herrjacob48-ui/inverted-pendulum-project/hardware/drawings/IP-M-002.png

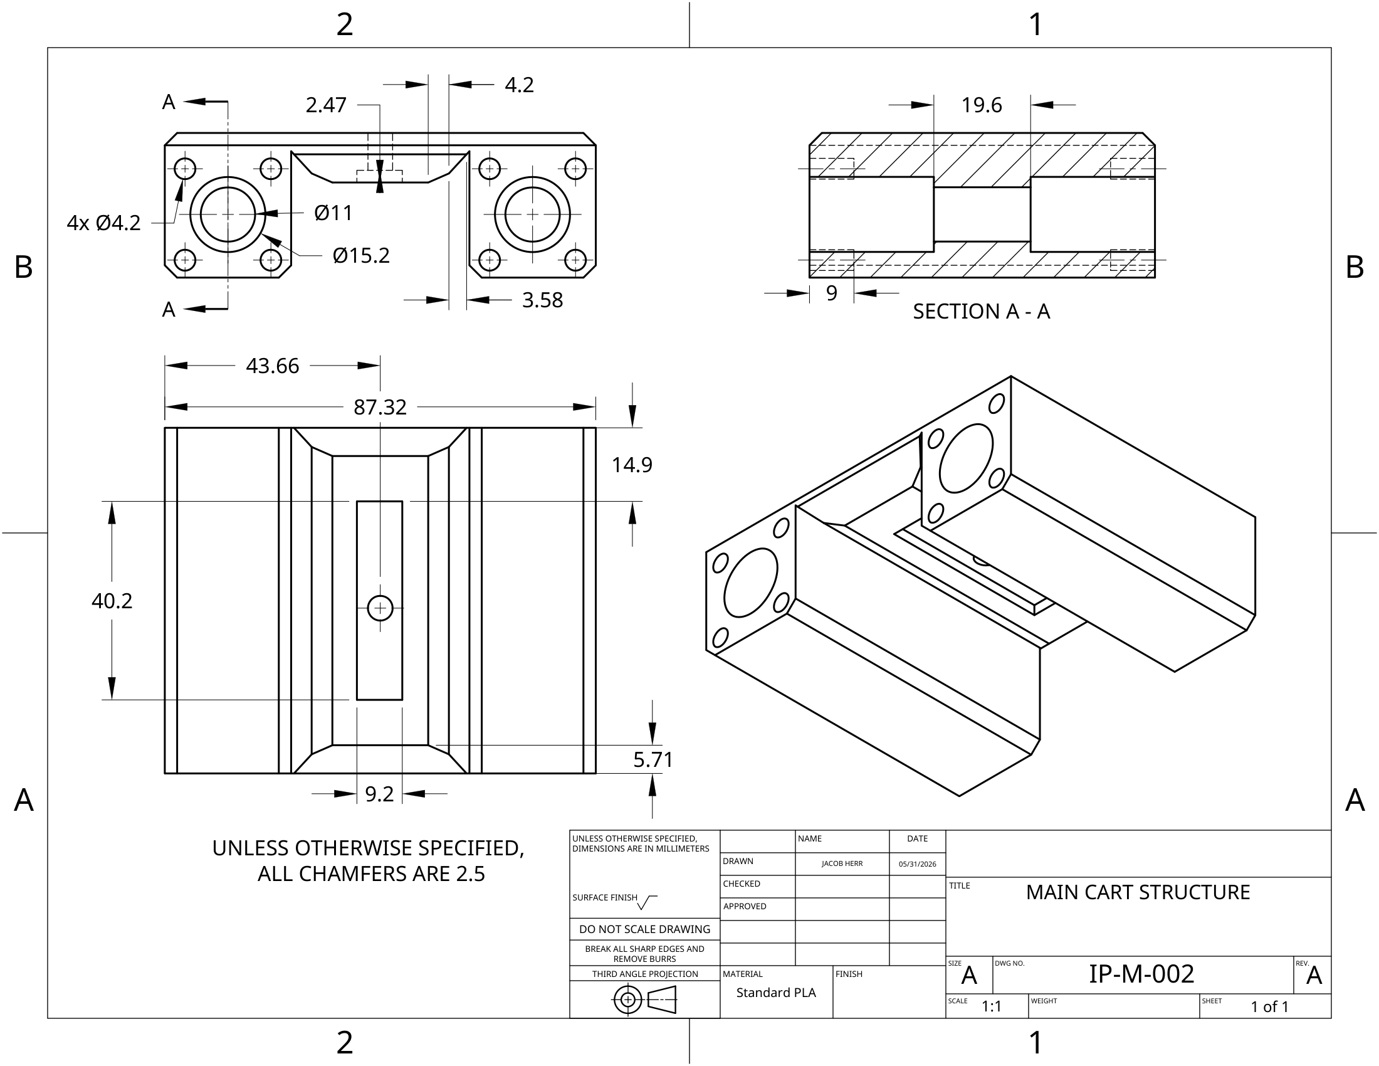
hardware/drawings/IP-M-002.png
