herrjacob48-ui/inverted-pendulum-project/hardware/cad/step/IP-M-001.step

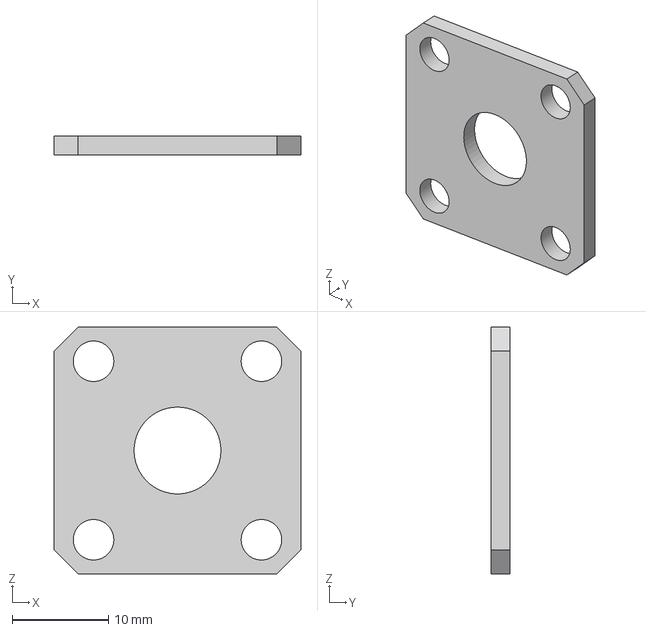
[picture p4: CAD file, 2026-10-11]
hardware/cad/step/IP-M-001.step
25.6 x 2.00 x 25.6 mm
