herrjacob48-ui/inverted-pendulum-project/hardware/cad/step/IP-M-003.step

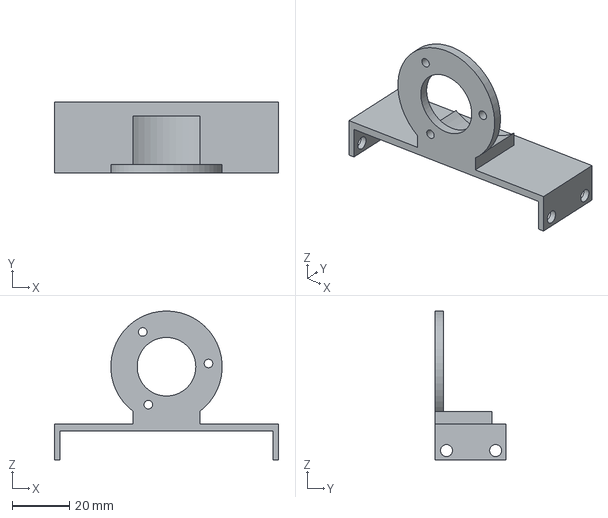
[picture p5: CAD file, 2026-10-11]
hardware/cad/step/IP-M-003.step
78.4 x 25.0 x 52.1 mm
