herrjacob48-ui/inverted-pendulum-project/hardware/cad/step/IP-M-005_IP-M-006.step

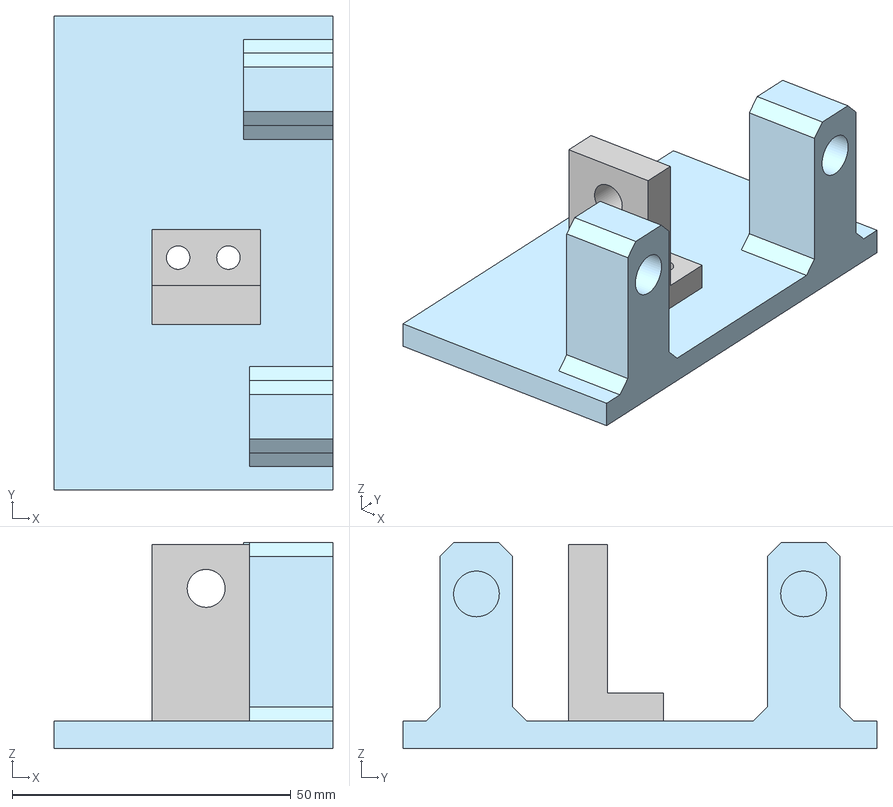
[picture p6: CAD file, 2026-10-11]
hardware/cad/step/IP-M-005_IP-M-006.step
50.0 x 85.0 x 37.0 mm
