herrjacob48-ui/inverted-pendulum-project/hardware/cad/step/IP-M-007.step

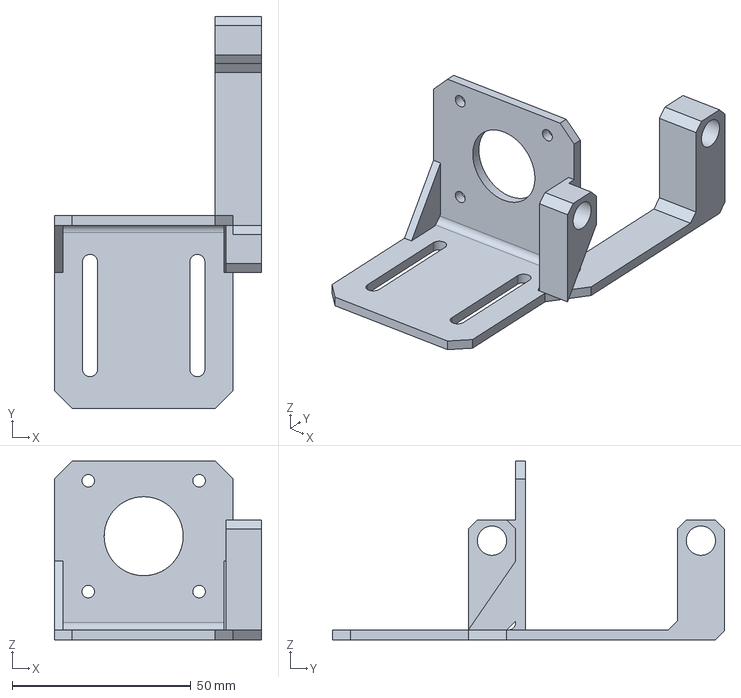
[picture p7: CAD file, 2026-10-11]
hardware/cad/step/IP-M-007.step
58.0 x 109.6 x 50.0 mm
