herrjacob48-ui/inverted-pendulum-project/hardware/cad/step/IP-M-004.step

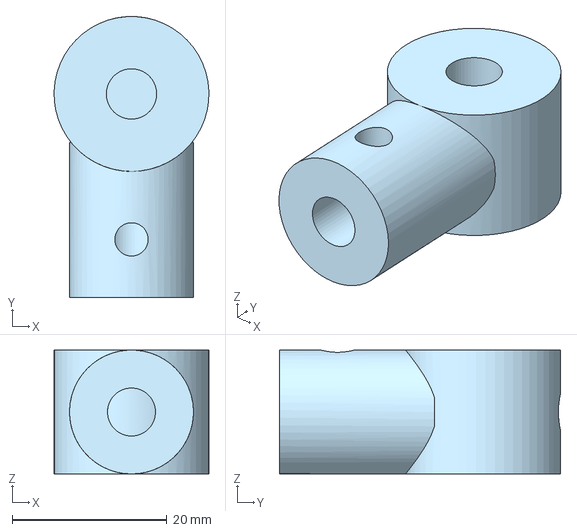
[picture p8: CAD file, 2026-10-11]
hardware/cad/step/IP-M-004.step
20.0 x 36.3 x 16.0 mm
