herrjacob48-ui/inverted-pendulum-project/hardware/cad/step/IP-M-002.step

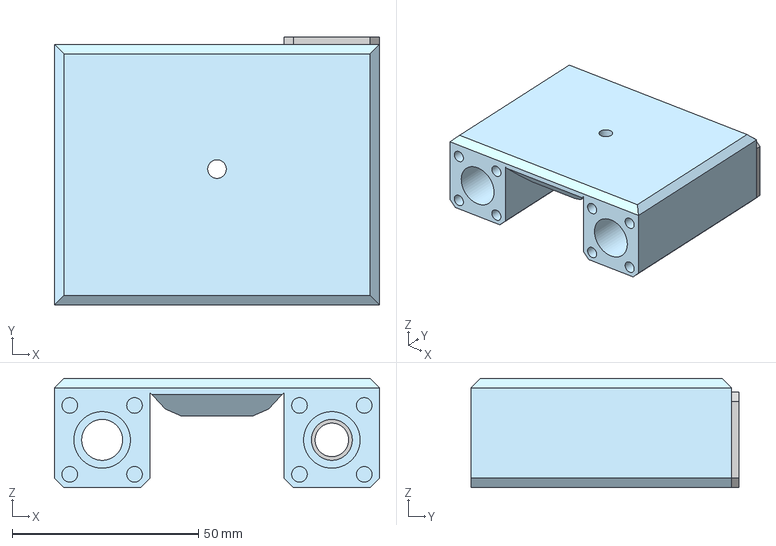
[picture p9: CAD file, 2026-10-11]
hardware/cad/step/IP-M-002.step
87.3 x 72.0 x 29.3 mm
