herrjacob48-ui/inverted-pendulum-project/(commit log)

2026-10-11 added drawing pdfs and step files for all custom parts.
    [IP-M-001.step, IP-M-002.step, IP-M-003.step, IP-M-004.step, IP-M-005_IP-M-006.step, IP-M-007.step]
2026-10-11 added wiring diagram
